hnz101/ELRS-Backpack-HeadTracker/case/Headtracker-Case_V6.3mf

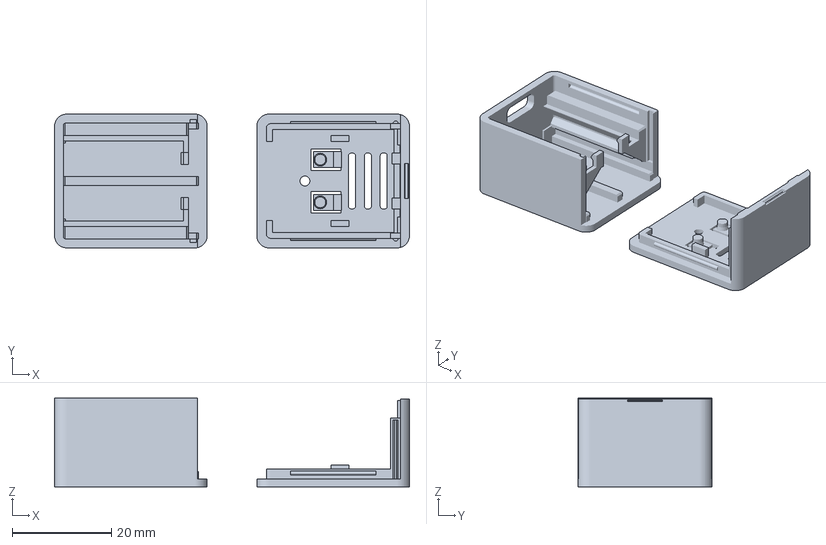
[picture p5: CAD file, 2026-10-17]
case/Headtracker-Case_V6.3mf
71.6 x 27.0 x 17.9 mm
