hnz101/ELRS-Backpack-HeadTracker/src/button_manager.h

#pragma once
#include <Arduino.h>
#include "my_config.h"

enum ButtonEvent
{
    BTN_NONE = 0,
    BTN_CENTER_CLICK,
    BTN_CENTER_LONG,
    BTN_ENTER_WEB_CONFIG,
    BTN_RIGHT_CLICK,
    BTN_LEFT_CLICK
};

class ButtonManager
{
public:
    ButtonManager();

    void begin();
    ButtonEvent update();

    // Set RGB LED color directly
    void setLed(uint8_t r, uint8_t g, uint8_t b);

    // Flash RGB LED for a temporary duration (ms), protecting it from heartbeat overwrite
    void flashLed(uint8_t r, uint8_t g, uint8_t b, uint32_t durationMs = 500);

    // Set heartbeat LED (only updates if no temporary flash is currently active)
    void setHeartbeatLed(uint8_t r, uint8_t g, uint8_t b);

    // Smooth breathing Magenta (#7A00B8) LED pattern for Web Configuration AP Mode
    // Respects temporary flashLed() overrides (Cyan for Center/Zero, Yellow for Tare IMU)
    void updateApModeLed();

    // Smooth pulsing Blue LED pattern during the 5-second power-up boot window
    void updateBootPulseLed();

    // Returns true if the BOOT / Center button (GPIO 9) is currently pressed OR was clicked during boot init
    bool isBootButtonPressed() const;
    bool wasBootButtonLatched() const;
    void clearBootButtonLatch();

private:
    uint32_t _btnCenterPressStart;
    bool     _btnCenterWasDown;
    bool     _btnCenterYellowShown;
    bool     _btnCenterWebFired;

    bool     _btnRightWasDown;
    bool     _btnLeftWasDown;

    uint32_t _flashUntil;
};
