hnz101/ELRS-Backpack-HeadTracker/(commit log)

2026-10-13 feat: add LOLIN S3 Mini Pro support with QMI8658 IMU headtracker, display, and ESP-NOW fixes
    [button_manager.cpp, button_manager.h, display_manager.cpp, display_manager.h, fake_vrx_fake_trainer.cpp, fake_vrx_fake_trainer.h, headtracker.cpp, headtracker.h]
2026-10-17 feat: Add Waveshare ESP32-C3 & BNO085 support with 3D quaternion decoupling, ASCII dashboard & configurable TX power
2026-10-17 Improve 9-DOF quaternion math, fix fusion mode switching/tare race, add NVS persistence, and update HANDOFF.md
    [headtracker.cpp, headtracker.h, main.cpp]
2026-10-17 docs: overhaul README.md for FPV HeadTracker, add 3D case & debug screenshot, remove cleartext binding phrase
    [Headtracker-Case_V6.3mf, Headtracker-Case_V6.scad]
2026-10-17 docs: add 3D case render and real-life build photos to README
2026-10-18 feat: add offline Wi-Fi Web-IF, 60 FPS 3D telemetry, dynamic ELRS UID hashing, and Wireless OTA
